bbogush/nand_programmer/kicad/adapter_soic8_solder/adapter_soic8_solder.kicad_pcb

## KiCad design kicad/adapter_soic8_solder/adapter_soic8_solder.kicad_pcb (2020-09-19)

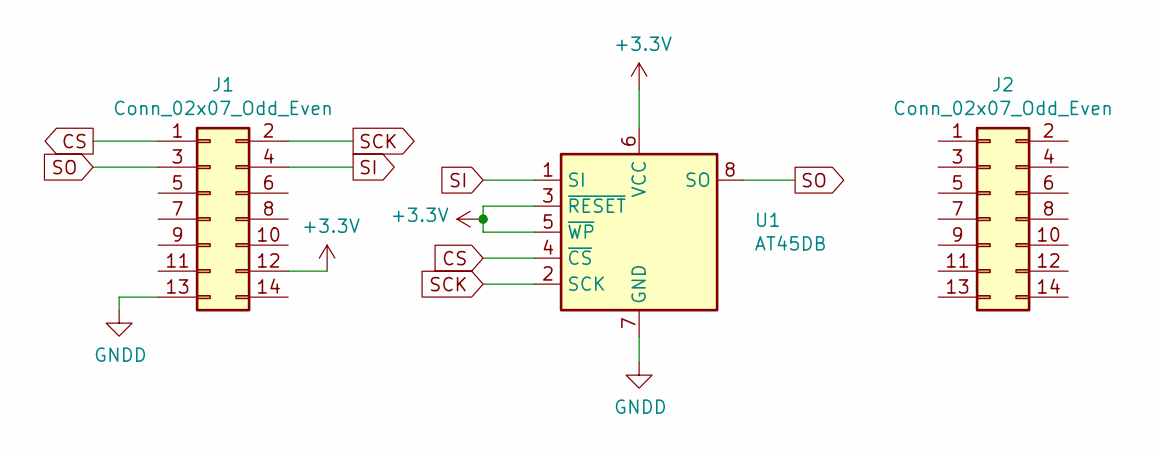
[picture p5: schematic adapter_soic8_solder.sch, NANDO SOIC-8 adapter solder]

Parts:
J1, J2: Conn_02x07_Odd_Even; PinSocket_2x07_P2.54mm_Vertical; Farnell Ref 1392520
U1: AT45DB; SOIC-8_3.9x4.9mm_P1.27mm

Connections:
+3V3: J1.12, U1.3 (~RESET~), U1.5 (~WP), U1.6 (VCC)
CS: J1.1, U1.4 (~CS)
GNDD: J1.13, U1.7 (GND)
SCK: J1.2, U1.2 (SCK)
SI: J1.4, U1.1 (SI)
SO: J1.3, U1.8 (SO)

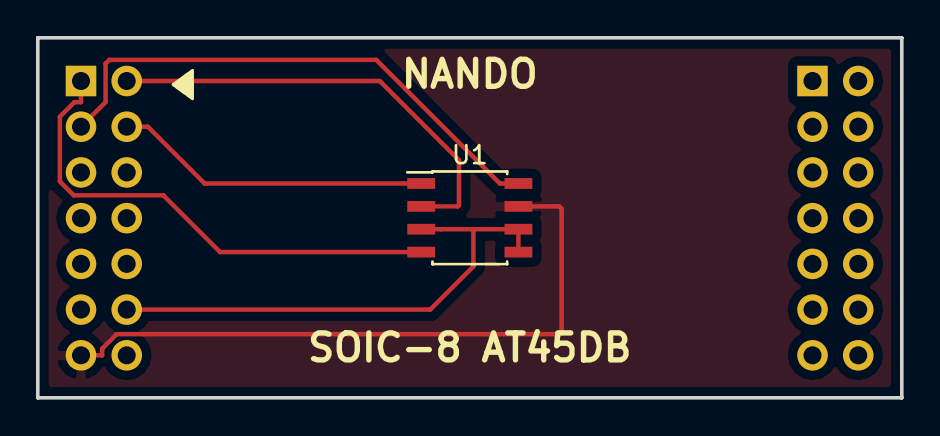
[picture p6: board adapter_soic8_solder.kicad_pcb from above]

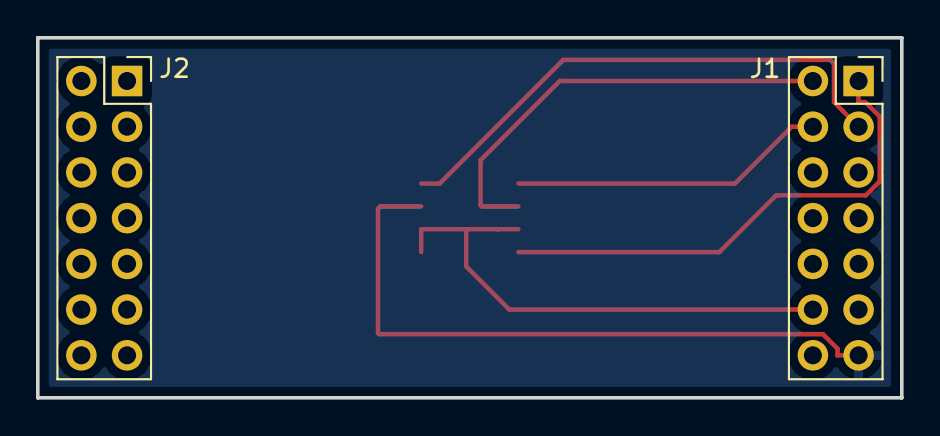
[picture p7: board adapter_soic8_solder.kicad_pcb from below]

Board: 2 copper layers, 48.0 x 20.0 mm, 3 parts (2 on the bottom side), 6 nets.
